JeremyRuhland/rbds_transmitter/README.md

RBDS Transmitter
----------------

Senior year project by Jeremy Ruhland, Spring 2014
Western Washington University, Electrical Engineering Technology
