JeremyRuhland/rbds_transmitter/bom.csv

Qty | Value | Device | Part Number
1 | TPS61030 | TPS61030 | 296-14416-1-ND
1 | SWITCH-SPSTSMD2 | SW1 | 401-1999-1-ND
2 | ATB3225-75034CT | SM-T4-2T | 445-9285-1-ND
1 | 16Mhz | RESONATORSMD | 490-1198-1-ND
1 | DIODESMA | D1 | 568-6370-1-ND
3 | P-CH | MOSFET-PCHANNELSMD | 785-1010-1-ND
1 | ATMEGA328 | ATMEGA168 | ATMEGA328-AU-ND
1 | USBMINIB | J1 | ED2992CT-ND
2 | TS974 | OPA4743UA | LMV324DR2GOSCT-ND
1 | MAX1551 | MAX1551 | MAX1551EZK+TCT-ND
1 | MCP4812 | MCP4812 | MCP4812-E/SN-ND
1 | AVRISP-6 | AVRISP-6 | N/A
1 | HD44780LCD-1602 | HD44780LCD-1602 | N/A
1 | M03PTH | P1 | N/A
1 | M023.5MM | P2 | N/A
1 | SOLDERJUMPER_2WAYS | SJ1 | N/A
8 | M01PTH | TP1,TP2,TP3,TP4,TP5,TP6,TP7,TP8 | N/A
1 | ANT | ANT1 | N/A
1 | M02-JST-2MM-SMT | B1 | 455-1749-1-ND
2 | BAS40-04 | BAS40-04 | 568-1624-1-ND
1 | 100uF | CPOL-US140CLH-1014 | 493-2113-1-ND
3 | 0.1uF | C-USC1206 | 399-1249-1-ND
3 | 10uF | C-USC1206 | 1276-1075-1-ND
3 | 1nF | C-USC1206 | 1276-2804-1-ND
4 | 1.2nF | C-USC1206 | 445-11634-1-ND
4 | 1.5nF | C-USC1206 | 490-8322-1-ND
4 | 3.9nF | C-USC1206 | 445-4003-1-ND
4 | 3nF | C-USC1206 | 490-6492-2-ND
10 | 1uF | C-USC1206 | 311-1181-1-ND
10 | 4.7uF | C-USC1206 | 587-1332-1-ND
2 | 10uH | L-USL1812 | 587-2433-1-ND
1 | 6.8uH | L-USL1812 | 587-2000-1-ND
1 | 485nH | L-USL3216C | 535-11687-1-ND
1 | MAX2606 | MAX2606 | MOUSER | 700-MAX2606EUTT
5 | 100k | R-TRIMM4G/J | 104ECT-ND
1 | 332 | R-US_R1206 | RMCF1206FT332RCT-ND
1 | 1.8M | R-US_R1206 | P1.80MFCT-ND
1 | 1.95M | R-US_R1206 | 311-1.96MFRCT-ND
1 | 200k | R-US_R1206 | RMCF1206FT200KCT-ND
1 | 390k | R-US_R1206 | RMCF1206FT390KCT-ND
2 | 100 | R-US_R1206 | RMCF1206FT100RCT-ND
2 | 200 | R-US_R1206 | RMCF1206FT200RCT-ND
3 | 1k | R-US_R1206 | RMCF1206FT1K00CT-ND
8 | 10k | R-US_R1206 | RMCF1206FT10K0CT-ND
12 | 100k | R-US_R1206 | RMCF1206FT100KCT-ND
16 | 2k | R-US_R1206 | RMCF1206FT2K00CT-ND
