JeremyRuhland/rbds_transmitter/rbds_transmitter.pdf

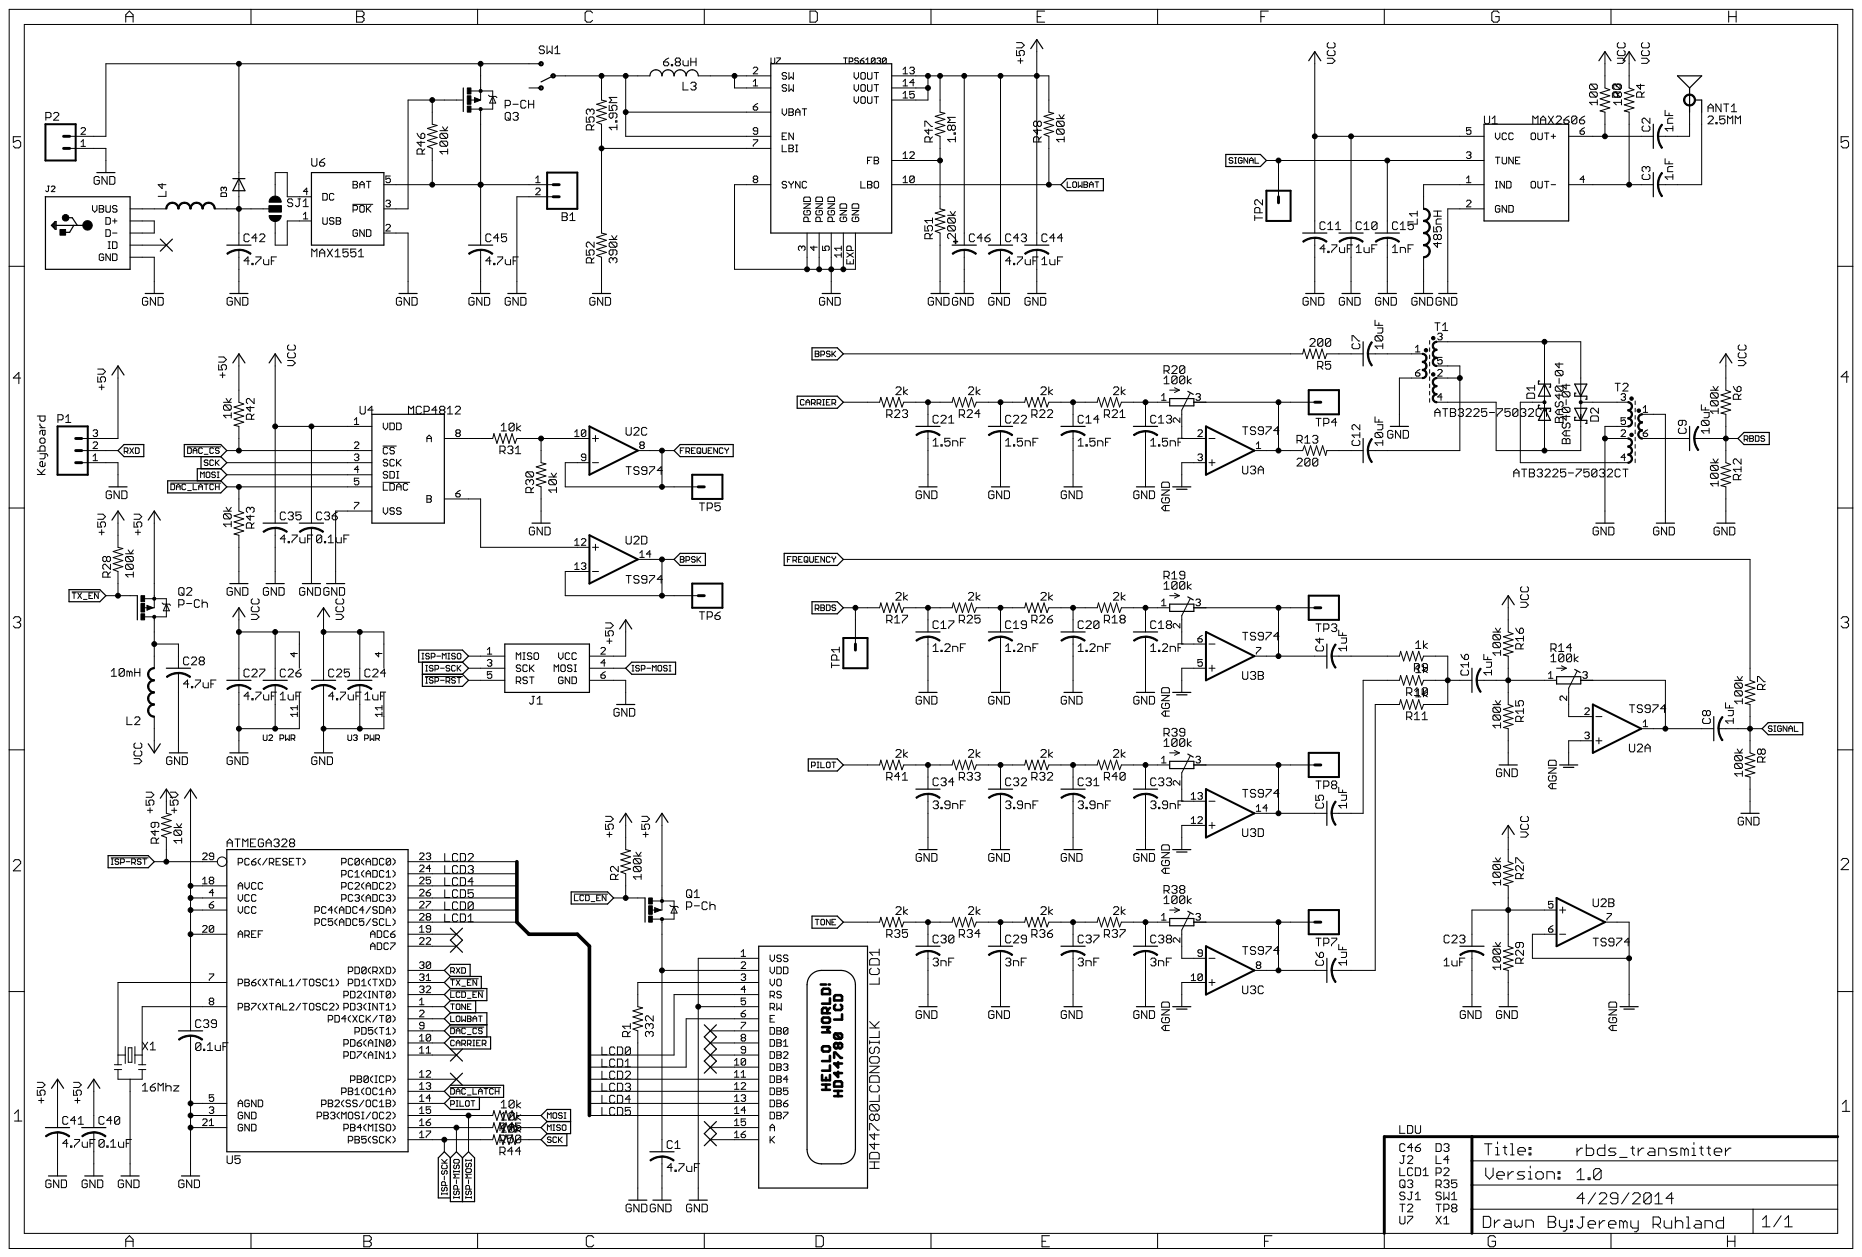
[picture p1: page 1]
