JeremyRuhland/rbds_transmitter/mixer_module.brd

## EAGLE design mixer_module.brd (2014-06-05)

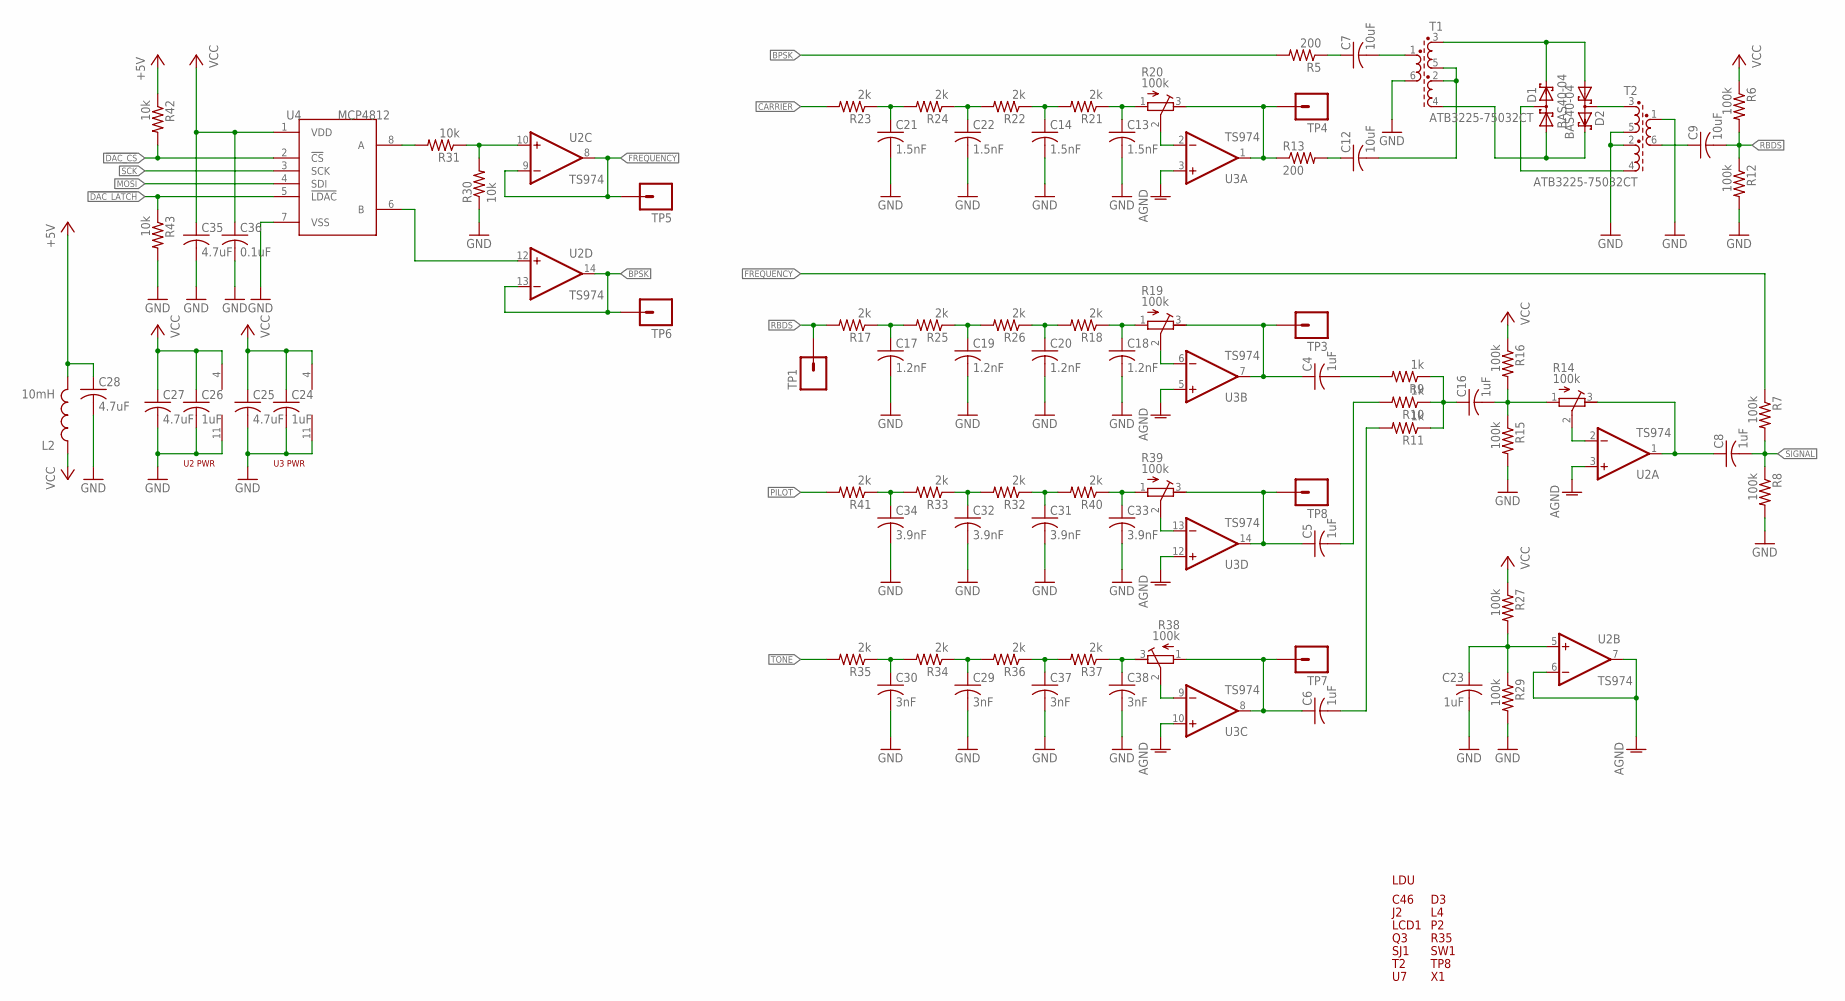
[picture p2: schematic mixer_module.sch]

Parts:
C4, C5, C6, C8, C16, C23, C24, C26: 1uF; C1206
C7, C9, C12: 10uF; C1206
C13, C14, C21, C22: 1.5nF; C1206
C17, C18, C19, C20: 1.2nF; C1206
C25, C27, C28, C35: 4.7uF; C1206
C29, C30, C37, C38: 3nF; C1206
C31, C32, C33, C34: 3.9nF; C1206
C36: 0.1uF; C1206
D1, D2: BAS40-04; SOT23
L2: 10mH; 1210
R5, R13: 200; R1206
R6, R7, R8, R12, R15, R16, R27, R29: 100k; R1206
R9, R10, R11: 1k; R1206
R14, R19, R20, R38, R39: 100k; RTRIM3304W
R17, R18, R21, R22, R23, R24, R25, R26, R32, R33, R34, R35, R36, R37, R40, R41: 2k; R1206
R30, R31, R42, R43: 10k; R1206
T1, T2: ATB3225-75032CT; TRANS
TP1, TP3, TP4, TP5, TP6, TP7, TP8: M01PTH; 1X01
U2, U3: TS974; SO14
U4: MCP4812; SO-08

Connections:
!DAC_CS: R42.2, U4.2 (!CS)
!DAC_LATCH: R43.1, U4.5 (!LDAC)
+5V: C28.1, L2.2, R42.1
AGND: U2.3 (+IN), U2.6 (-IN), U2.7 (OUT), U3.3 (+IN), U3.5 (+IN), U3.10 (+IN), U3.12 (+IN)
BPSK: R5.2, TP6.1, U2.13 (-IN), U2.14 (OUT)
CARRIER: R23.2
FREQUENCY: R7.1, TP5.1, U2.8 (OUT), U2.9 (-IN)
GND: C13.2, C14.2, C17.2, C18.2, C19.2, C20.2, C21.2, C22.2, C23.2, C24.2, C25.2, C26.2, C27.2, C28.2, C29.2, C30.2, C31.2, C32.2, C33.2, C34.2, C35.2, C36.2, C37.2, C38.2, R8.2, R12.2, R15.2, R29.2, R30.1, R43.2, T1.6, T2.1, T2.2, T2.5, U2.11 (V-), U3.11 (V-), U4.7 (VSS)
MOSI: U4.4 (SDI)
unnamed: C38.1, R37.1, R38.3 (E)
unnamed: D1.3 (C1A2), T2.4
unnamed: C16.2, R14.1 (A), R15.1, R16.2
unnamed: D2.3 (C1A2), T2.3
unnamed: D1.2 (C2), D2.1 (A1), T1.3
unnamed: D1.1 (A1), D2.2 (C2), T1.4
unnamed: C12.2, T1.2, T1.5
unnamed: C7.2, T1.1
unnamed: R14.2 (S), U2.2 (-IN)
unnamed: C8.1, R14.3 (E), U2.1 (OUT)
unnamed: C7.1, R5.1
unnamed: C12.1, R13.2
unnamed: R31.2, U4.8 (A)
unnamed: U2.12 (+IN), U4.6 (B)
unnamed: C9.1, T2.6
unnamed: R30.2, R31.1, U2.10 (+IN)
unnamed: C21.1, R23.1, R24.2
unnamed: C22.1, R22.2, R24.1
unnamed: C19.1, R25.1, R26.2
unnamed: C20.1, R18.2, R26.1
unnamed: C18.1, R18.1, R19.1 (A)
unnamed: C13.1, R20.1 (A), R21.1
unnamed: R19.2 (S), U3.6 (-IN)
unnamed: C4.1, R19.3 (E), TP3.1, U3.7 (OUT)
unnamed: C23.1, R27.2, R29.1, U2.5 (+IN)
unnamed: C32.1, R32.2, R33.1
unnamed: C31.1, R32.1, R40.2
unnamed: C33.1, R39.1 (A), R40.1
unnamed: R39.2 (S), U3.13 (-IN)
unnamed: C5.1, R39.3 (E), TP8.1, U3.14 (OUT)
unnamed: C29.1, R34.1, R36.2
unnamed: C37.1, R36.1, R37.2
unnamed: C6.1, R38.1 (A), TP7.1, U3.8 (OUT)
unnamed: R38.2 (S), U3.9 (-IN)
unnamed: R20.2 (S), U3.2 (-IN)
unnamed: C4.2, R9.2
unnamed: C5.2, R10.2
unnamed: C6.2, R11.2
unnamed: C16.1, R9.1, R10.1, R11.1
unnamed: R13.1, R20.3 (E), TP4.1, U3.1 (OUT)
unnamed: C17.1, R17.1, R25.2
unnamed: C34.1, R33.2, R41.1
unnamed: C30.1, R34.2, R35.1
unnamed: C14.1, R21.2, R22.1
PILOT: R41.2
RBDS: C9.2, R6.2, R12.1, R17.2, TP1.1
SCK: U4.3 (SCK)
SIGNAL: C8.2, R7.2, R8.1
TONE: R35.2
VCC: C24.1, C25.1, C26.1, C27.1, C35.1, C36.1, L2.1, R6.1, R16.1, R27.1, U2.4 (V+), U3.4 (V+), U4.1 (VDD)

Notes on the sheet:
LDU
C46
LCD1
R35
SJ1
TP8
SW1
U2 PWR
U3 PWR

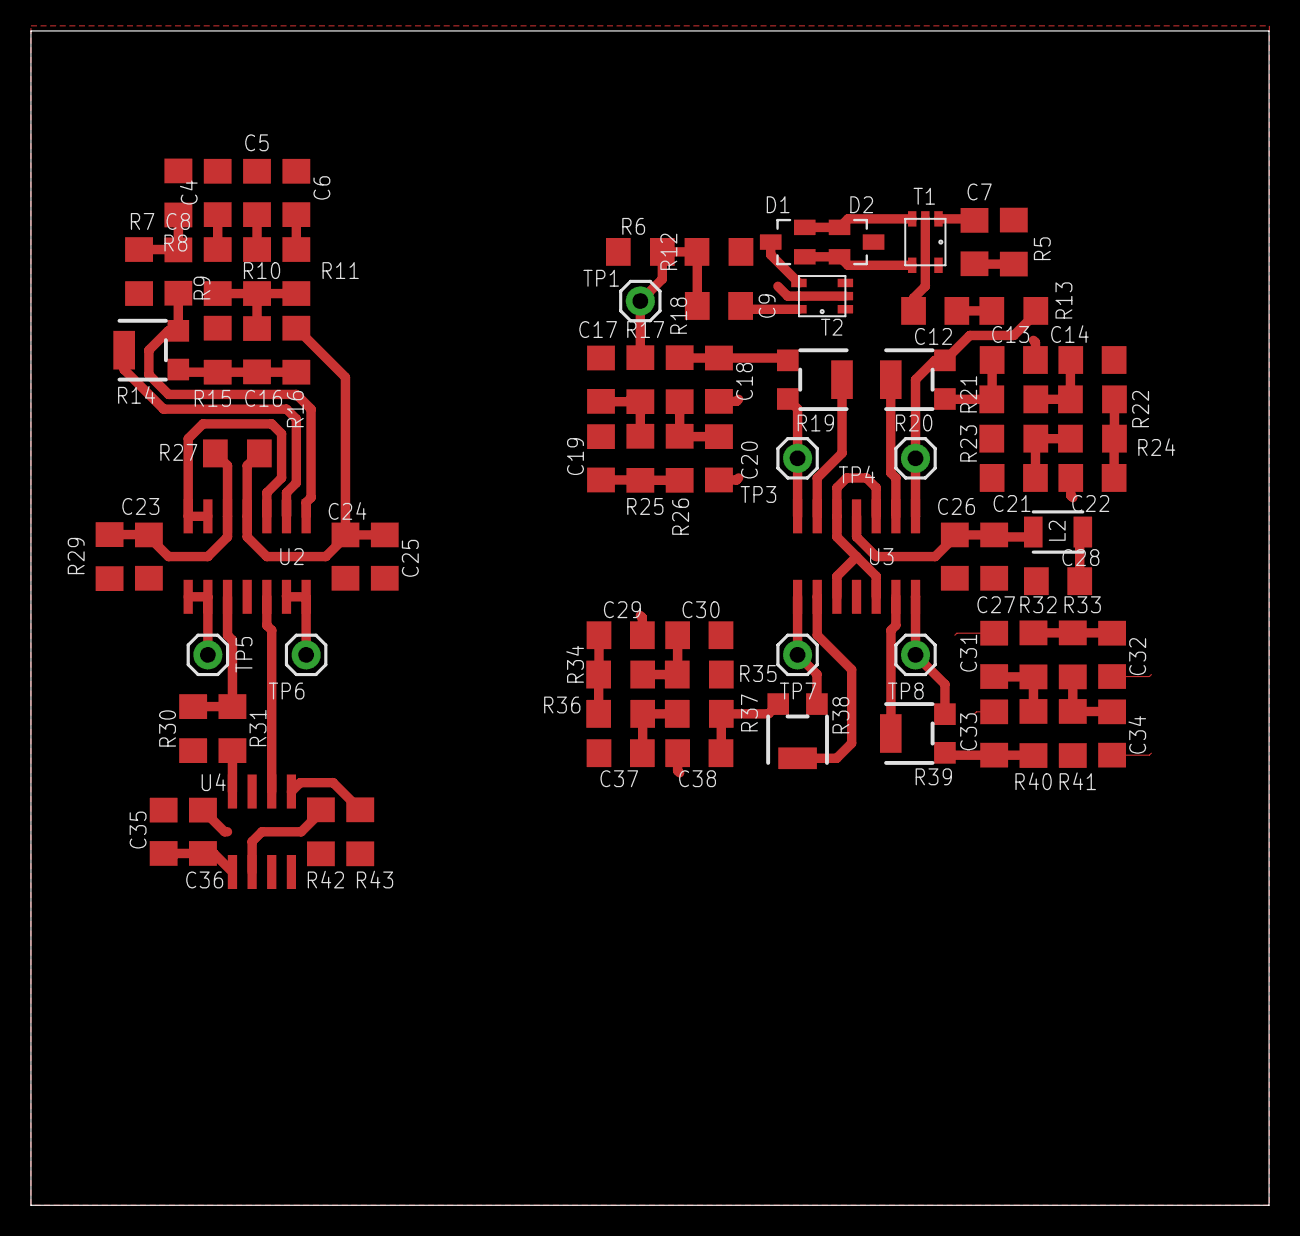
[picture p3: board mixer_module.brd from above]

Board: 2 copper layers, 80.0 x 75.9 mm, 85 parts (0 on the bottom side), 54 nets.
