JeremyRuhland/rbds_transmitter/vco_module.brd

## EAGLE design vco_module.brd (2014-06-05)

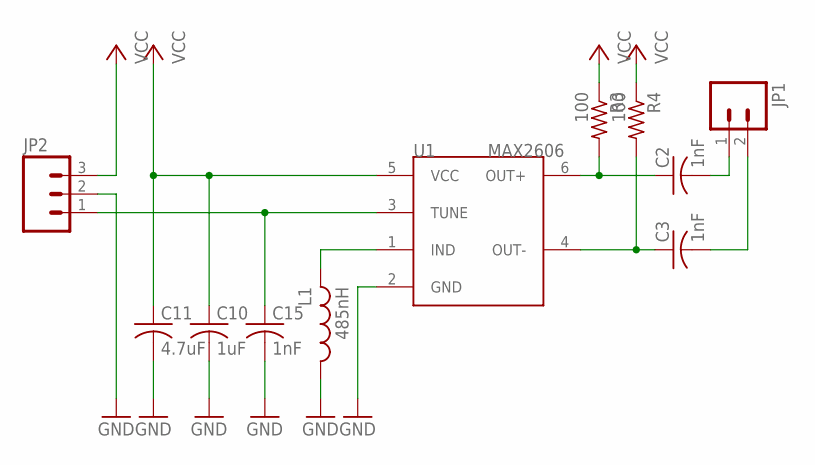
[picture p4: schematic vco_module.sch]

Parts:
C2, C3, C15: 1nF; C050-025X075
C10: 1uF; C050-025X075
C11: 4.7uF; C050-025X075
JP1: M023.5MM; SCREWTERMINAL-3.5MM-2
JP2: M03PTH; 1X03
L1: 485nH; 0204V
R3, R4: 100; 0207/10
U1: MAX2606; SOT23-6L

Connections:
GND: C10.2, C11.2, C15.2, JP2.2, L1.1, U1.2 (GND)
unnamed: L1.2, U1.1 (IND)
unnamed: C2.1, R3.2, U1.6 (OUT+)
unnamed: C3.1, R4.2, U1.4 (OUT-)
unnamed: C2.2, JP1.1
unnamed: C3.2, JP1.2
SIGNAL: C15.1, JP2.1, U1.3 (TUNE)
VCC: C10.1, C11.1, JP2.3, R3.1, R4.1, U1.5 (VCC)

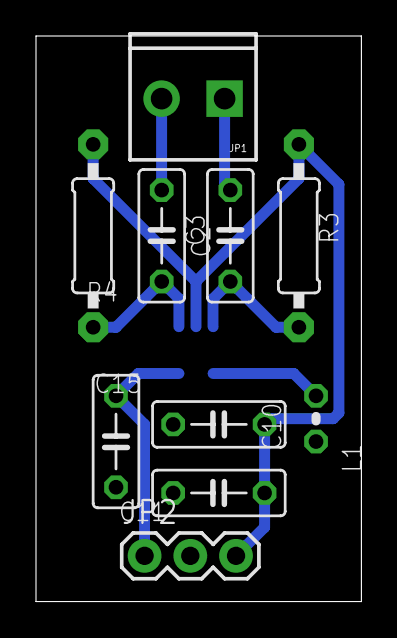
[picture p5: board vco_module.brd from above]

Board: 2 copper layers, 18.1 x 31.4 mm, 11 parts (1 on the bottom side), 8 nets.
