JeremyRuhland/rbds_transmitter/firmware/uart.h

/******************************************************************************
* UART Communication Module                                                   *
*                                                                             *
* Contains functions and definitions required for 2014 ROV motherboard        *
*                                                                             *
*                                                                             *
* (void) uartInit(void)         Function initializes the UART system into     *
*                               8-bit, 1 stop bit, no parity mode.            *
* (uint8_t) uartRx(void)        Function returns byte waiting in the UART Rx  *
*                               register, returns null (0x00) if empty.       *
*                                                                             *
******************************************************************************/

extern void uartInit(void);
extern uint8_t uartRx(void);
