JeremyRuhland/rbds_transmitter/(commit log)

2014-04-08 begun laying out circuit, uC & battery charger
    [rbds_transmitter.sch]
2014-04-09 added switching regulator
    [rbds_transmitter.sch]
2014-04-09 added dac, finished regulator
    [rbds_transmitter.sch]
2014-04-09 wiring up dac
    [rbds_transmitter.sch]
2014-04-10 added diode ring mixer
    [rbds_transmitter.sch]
2014-04-12 adding summing amp
    [rbds_transmitter.sch]
2014-04-14 added low pass filter
    [rbds_transmitter.sch]
2014-04-14 adding low pass for pilot tones
    [rbds_transmitter.sch]
2014-04-17 didn't really actually work after class
    [rbds_transmitter.sch]
2014-04-19 adding filters for pilot/sound
    [rbds_transmitter.sch]
2014-04-20 more filters
    [rbds_transmitter.sch]
2014-04-20 yet more filters
    [rbds_transmitter.sch]
2014-04-22 seperated out some parts
    [rbds_transmitter.sch]
2014-04-24 fixed up usb charger for load switching, worked some on op amps
    [rbds_transmitter.sch]
2014-04-25 still working
    [rbds_transmitter.sch]
2014-04-27 adding tx
    [rbds_transmitter.sch]
2014-04-28 rebuilding filter systems
    [rbds_transmitter.sch]
2014-04-28 need to wire subsystems to mcu
    [rbds_transmitter.sch]
2014-04-29 finished prelim layout
    [rbds_transmitter.sch]
2014-05-01 final design tweaks for hardware descript
    [rbds_transmitter.brd, rbds_transmitter.sch]
2014-05-01 added value to r15, erexported
    [rbds_transmitter.brd, rbds_transmitter.sch]
2014-05-04 added bom
    [bom.csv, rbds_transmitter.brd]
2014-05-05 added more part nums
    [bom.csv]
2014-05-05 another bom entry
    [bom.csv]
2014-05-06 found all components
    [bom.csv]
2014-05-11 layed out some power components
    [rbds_transmitter.brd]
2014-05-15 schematic update: corrected 5v connection
    [rbds_transmitter.brd, rbds_transmitter.sch]
2014-05-20 changed transformer layout
    [rbds_transmitter.brd, rbds_transmitter.sch]
2014-05-20 layed out some more traces
    [rbds_transmitter.brd, rbds_transmitter.sch]
2014-05-22 swapped u3c and u3d
    [rbds_transmitter.brd, rbds_transmitter.sch]
2014-05-23 wiring up modules
    [rbds_transmitter.brd]
2014-05-24 changed mcu agnd to gnd: request engineering change form
    [rbds_transmitter.brd]
2014-05-24 few more airwires
    [rbds_transmitter.brd, rbds_transmitter.sch]
2014-05-24 renubmered everything, request engineering change forum
    [rbds_transmitter.brd, rbds_transmitter.sch]
2014-05-24 board ready for gerbering
    [rbds_transmitter.brd]
2014-05-24 added silkscreens
    [rbds_transmitter.brd]
2014-05-24 last minutes changes, board finalized
    [rbds_transmitter.brd]
2014-05-26 removed unneeded spi function
2014-05-26 fixed spi code for writing to dac
    [spi.c, spi.h]
2014-05-26 fixing up spi for dac control
    [spi.c]
2014-05-27 corrected group type error, cd to b
    [main.c]
2014-05-27 corrected a few variable errors, code compiles now
    [main.c]
2014-05-28 corrected spelling mistake bin to bit
    [main.c]
2014-05-28 crc is probably wrong still
    [crc.c]
2014-05-28 corrected end of msg by adding return char and new packets as nessesary
    [main.c]
2014-05-29 working on pwm
2014-05-29 engineering change request form: swapped pd6 and pb1
    [rbds_transmitter.brd, rbds_transmitter.sch]
2014-05-29 engineering change request form: swapped pd6 and pb1, reexported files
    [rbds_transmitter.sch]
2014-05-29 swapped to new dac latch port
    [spi.c]
2014-05-29 pwm inits written, power control written
2014-05-29 making some code corrections
    [crc.h, includes.h, main.c, spi.h, uart.c, uart.h]
2014-05-31 starting to split up board into smaller millable boards
    [mixer_module.brd, mixer_module.sch, vco_module.brd, vco_module.sch]
2014-06-02 reworked from oneil's lcd lib
    [lcd.c, lcd.h]
2014-06-03 fixed up code, proper pwm working
    [main.c]
2014-06-04 fixed for boardmill
    [vco_module.brd]
2014-06-05 final changes to unused external boards
    [mixer_module.brd, mixer_module.sch, vco_module.brd, vco_module.sch]
